stuartpittaway/RFM2Pi/hardware/readme.md

## RFM2Pi

A collaboration between Martin Harizanov and OpenEnergyMonitor. Martin's origional repo: https://github.com/mharizanov/RFM2Pi/

### Schematic and board files: 

See board folder

### Schematic



Download schematic: [https://raw.githubusercontent.com/openenergymonitor/RFM2Pi/master/hardware/RFM12Pi_V2.6/RFM2Pi_v2.6.sch](https://raw.githubusercontent.com/openenergymonitor/RFM2Pi/master/hardware/RFM12Pi_V2.6/RFM2Pi_v2.6.sch)

### Board



Download board: [https://raw.githubusercontent.com/openenergymonitor/RFM2Pi/master/hardware/RFM12Pi_V2.6/RFM2Pi_v2.6.brd](https://raw.githubusercontent.com/openenergymonitor/RFM2Pi/master/hardware/RFM12Pi_V2.6/RFM2Pi_v2.6.brd)

### Open Hardware

Hardware designs (schematics and CAD) files are licensed under the [Creative Commons Attribution-ShareAlike 3.0 Unported License](http://creativecommons.org/licenses/by-sa/3.0/) and follow the terms of the [OSHW (Open-source hardware) Statement of Principles 1.0.](http://freedomdefined.org/OSHW)
