stuartpittaway/RFM2Pi/docs/img/v3/RFm69PiV3_1_brd.jpg

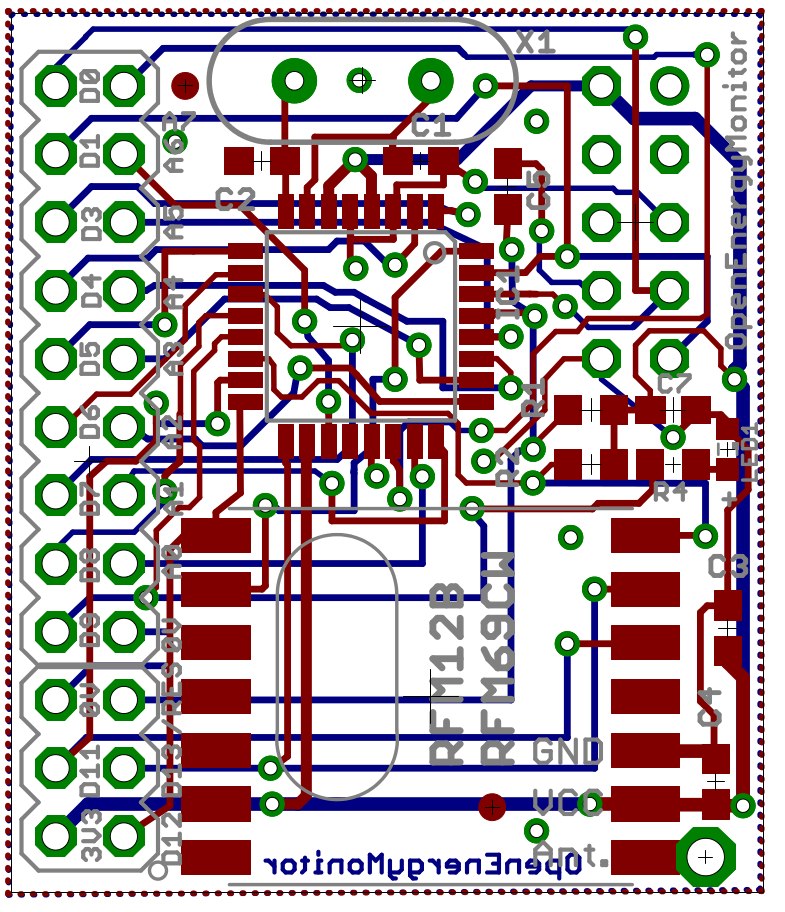
docs/img/v3/RFm69PiV3_1_brd.jpg
