stuartpittaway/RFM2Pi/docs/img/v3/RFm69PiV3_1_sch.png

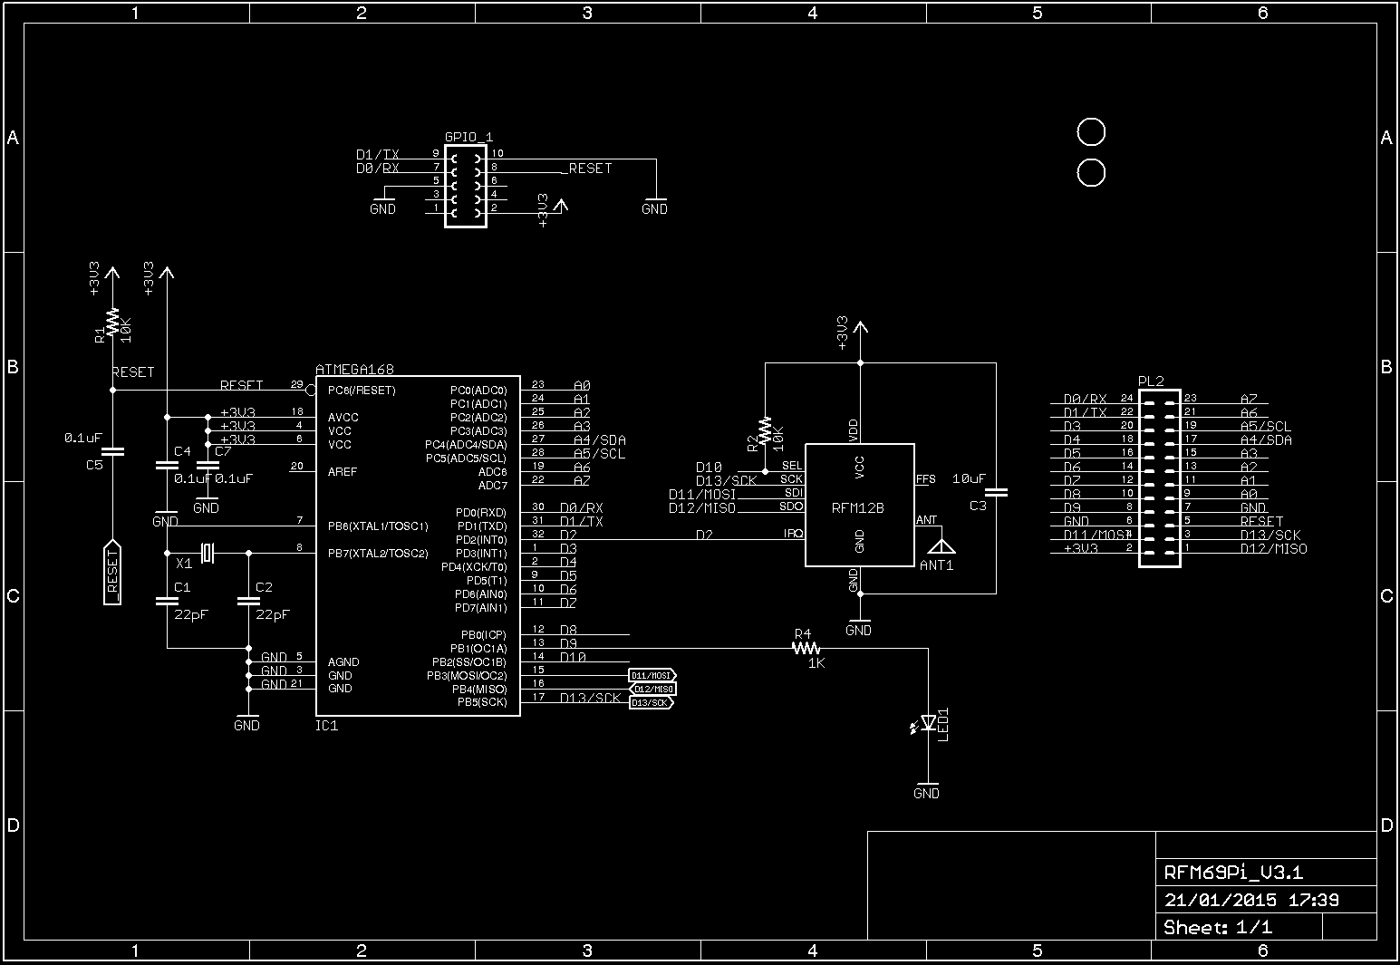
docs/img/v3/RFm69PiV3_1_sch.png
