stuartpittaway/RFM2Pi/(commit log)

2023-09-04 Update boards.txt entry for Arduino IDE
    Added definitions required by newer versions of Arduino IDE
    upload.tool, bootloader.tool, build.board, etc.
2023-09-04 Update rfm69pi_v3.md - Bootloader instructions
    Added more detailed instructions in the "Modified Bootloader" section as to where to obtain the pre-compiled .hex and instructions for including it in the boards.txt entry so it can be burned to the board from Arduino IDE.
